YunKiNoh/MIP-2024-2-Inline-3D-Scanning-Prototype-System-with-2D-Camera-and-Line-Laser/Product Information/Line Laser/PinColor.txt

Pin1[VCC]: Brown
Pin2[DIG]: White
Pin3[GND]: Blue
Pin4[ANA]: Black
Pin5[FAIL]: Gray
