YunKiNoh/MIP-2024-2-Inline-3D-Scanning-Prototype-System-with-2D-Camera-and-Line-Laser/LAB Seminar/5week_Report.pptx

## 24년도 2학기 5주차 기전융합프로젝트 보고서

지도교수님: 기계제어공학부 김영근 교수님
21800226 노윤기

## 목차

- 연구주제 소개
- 진행상황
- 향후 계획

## 연구주제

2d Camera와 Laser를 통해 3d Scanning System 구축하기

1. 2d camera 선정 이유: 3d 카메라의 이점인 depth 정보를 2d로 구현하여 비용절감
→ 삼각 측량법에서는 “해상도, 픽셀 사이즈, 센서 사이즈” 기능이 중요함

2. 구현 가능성: inline scanning에서는 고정된 위치를 통해 높이 검출 가능
→ 삼각 측량법을 통해 2d 카메라에 인식된 레이저 포인터로 높이 검출 가능

## 삼각법 적용 구성도

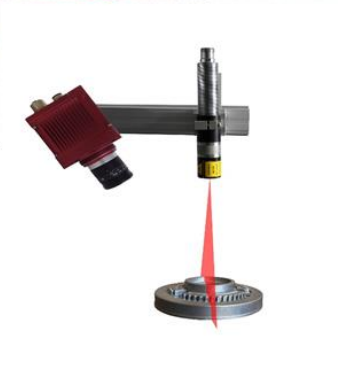
[picture p16: figure]
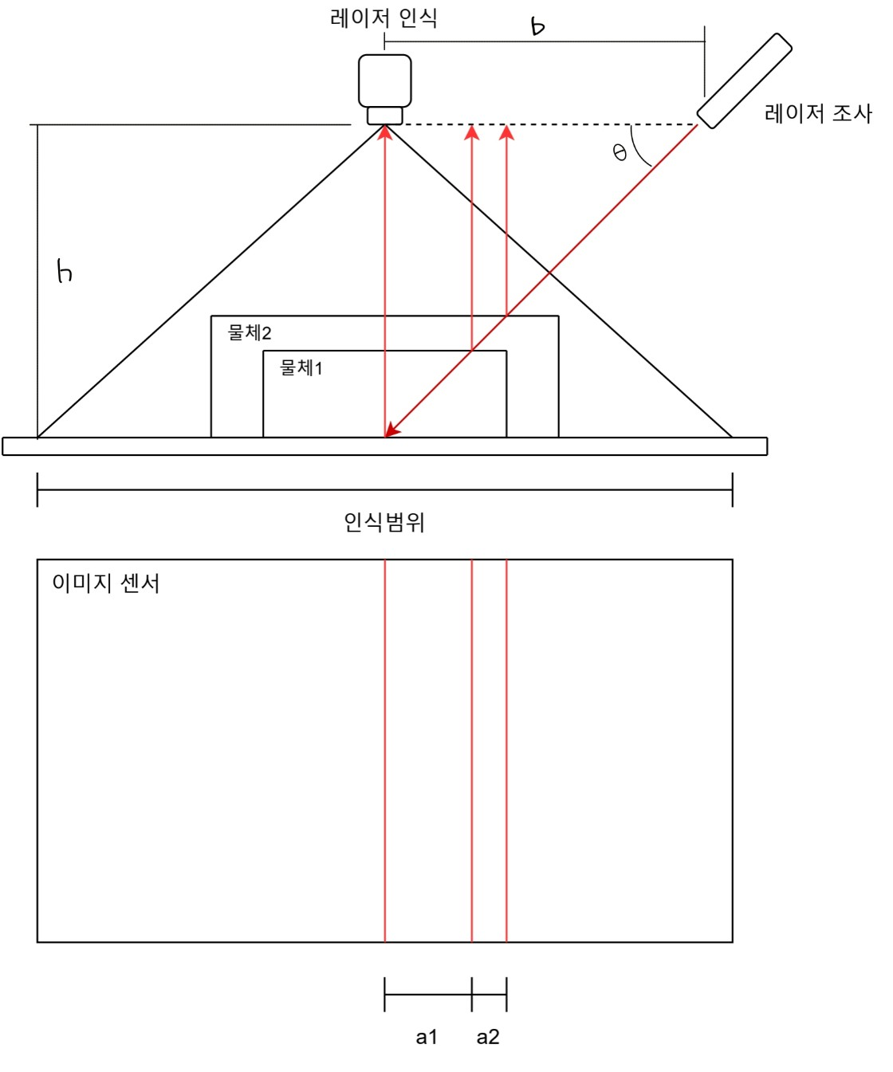
[picture p17: figure]
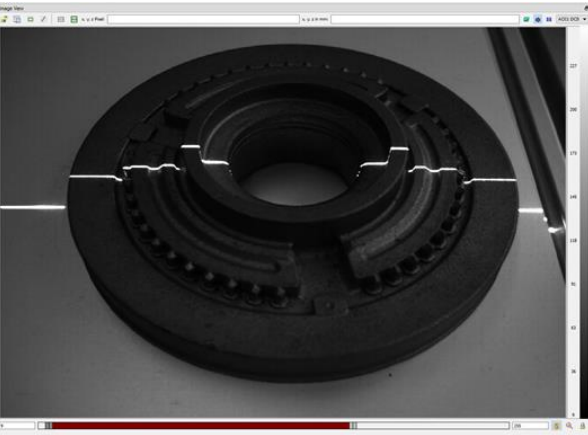
[picture p18: figure]
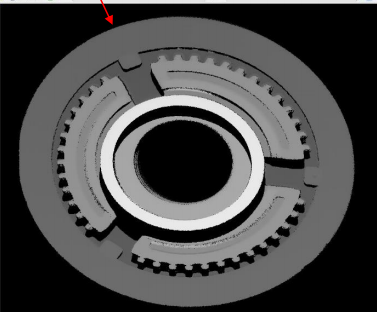
[picture p19: figure]

1. h, b, theta 지정
2. 물체의 높이에 따른 레이저 위치의 변화 → 삼각형의 닮음비로 높이 계산

## 진행상황

전체 목표:
1. 소프트웨어
  1. 캘리브레이션: 내부/외부 파라미터
  2. 3D 스캔: 레이저 검출, 높이 계산, GUI
2. 하드웨어
  1. 카메라/레이저 선정:
  2. 카메라/레이저 통합: 각도,거리 선정
  3. 전체 뼈대: 프로토타입/메인 뼈대
  4. 구동장치: 3d scan box / 카메라 슬라이드 활용

지난 목표:
1. 삼각법 프로토타입 구축
  1. 캘리브레이션
  2. 카메라, 레이저 고정
  3. 삼각법 적용
2. Z Laser 대체품 파악
  1. Z series 견적서
  2. ‘두께,DOF,출력’ 기준 대체품 파악
3. 2d camera의 적합성 파악
  1. 2D 카메라와 3D 카메라의 차이 및 사용 용도
4. 연구계획표 작성

## 진행상황

1. 카메라 내부 파라미터 추출

2. Z Laser 대체품 파악 및 정리

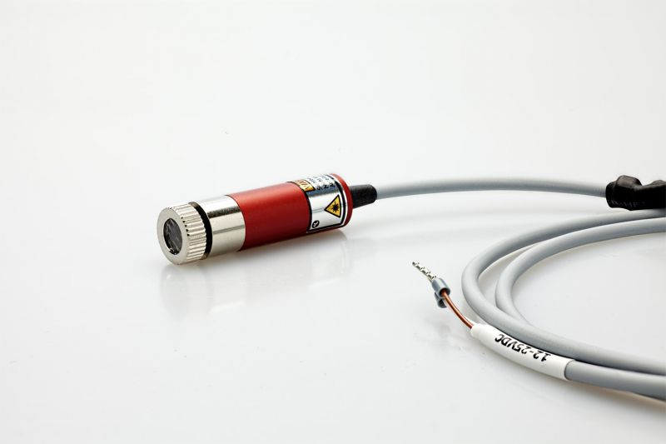
[picture p20: figure]
12 - 24 VDC cable finish

LLM-100-650 of MediaLas

3. 구현 계획 수립

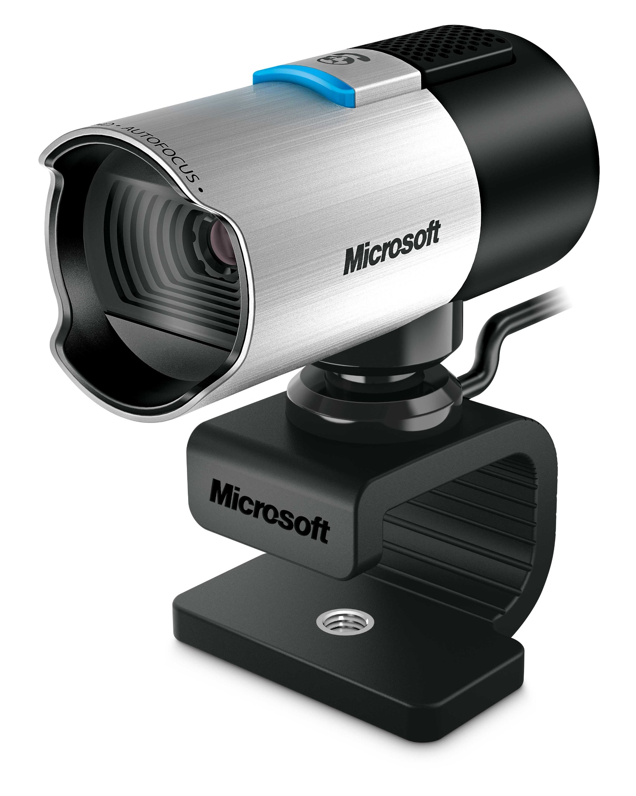
[picture p21: figure]
Microsoft LifeCam Studio Full HD 1080p : Electronics - Amazon.com

계획표[엑셀 파일]

Microsoft LifeCam Studio

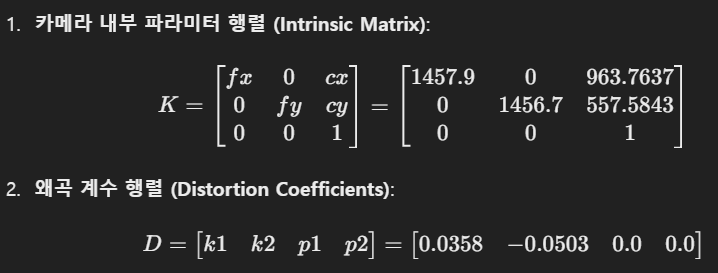
[picture p22: figure]
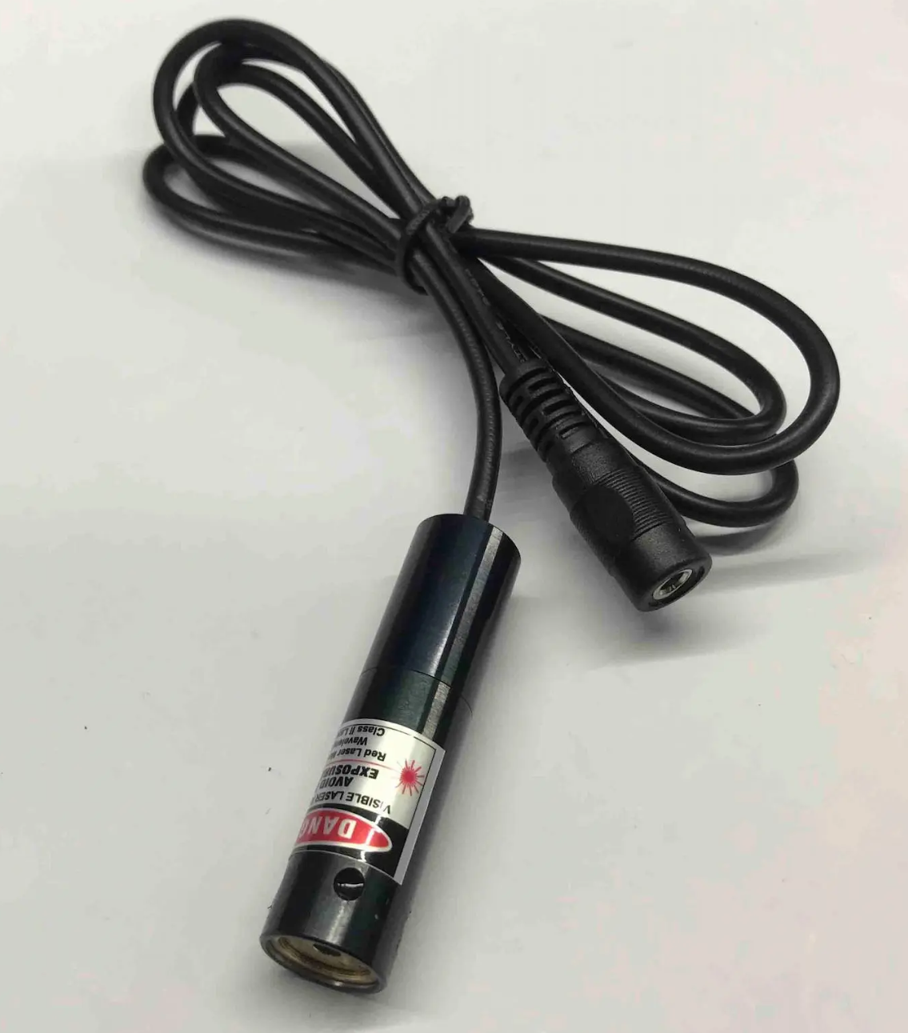
[picture p23: figure]

AM650U50G1 of AIMLASER

## 다음계획(5~6주차): 1. 3d 스캔 구현 2. 레이저 구입 3. 구동 장치 선정

1차 뼈대 구축[5주차] | 삼각법 프로토타입 구축[6주차] | 레이저/카메라 확정[6주차] | 구동장치[6주차]
기본 카메라/ 기본 레이저 고정 | 외부 파라미터 | 레이저 선정 및 주문 | 슬라이드 적용 검토 및 결정
1차 뼈대 구축 | 픽셀 실제 거리 계산 | 카메라 선정(검토 및 선정)
카메라, 레이저 고정한 뼈대 제작 | 정지상태 높이 검출 및 plot
| 정지상태 정확도 평가
| 이동하는 물체 스캔[plot, 정확도]
