YunKiNoh/MIP-2024-2-Inline-3D-Scanning-Prototype-System-with-2D-Camera-and-Line-Laser/Product Information/Telecentric Lens/F_Optimized_with_4.65um_pixel_image_sensor.pdf

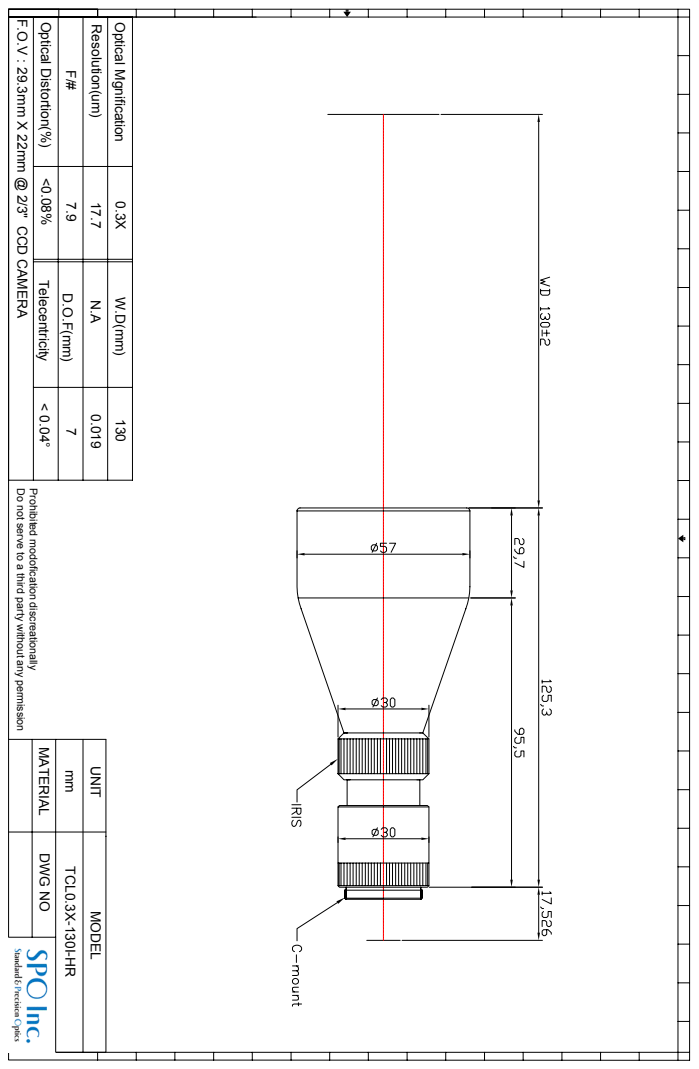
[picture p24: page 1]

F.O.V : 29.3mm X 22mm @ 2/3" CCD CAMERA 0.3X 130 17.7 0.019 7.9 7 <0.08% < 0.04° Prohibited modofication discreationally Do not serve to a third party without any permission

Optical Distortion(%) Telecentricity

mm UNIT MODEL TCL0.3X-130I-HR DWG NO MATERIAL Resolution(um)

Optical Mgnification N.A W.D(mm) F/# D.O.F(mm)
